jasonkresch/quantum-entanglement/media/vertical-cosmic-ray-telescope-3.jpg

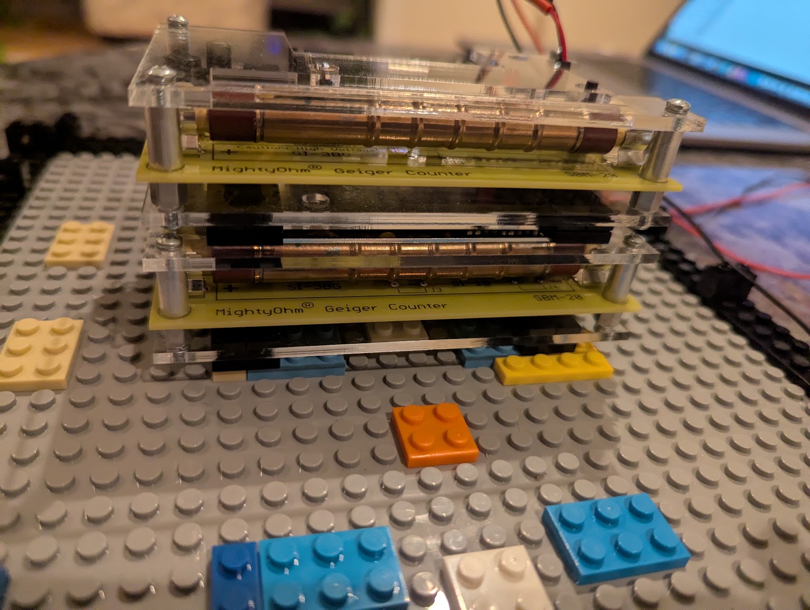
media/vertical-cosmic-ray-telescope-3.jpg
