jasonkresch/quantum-entanglement/related-docs/Entanglement-Demo-Shopping-List.pdf

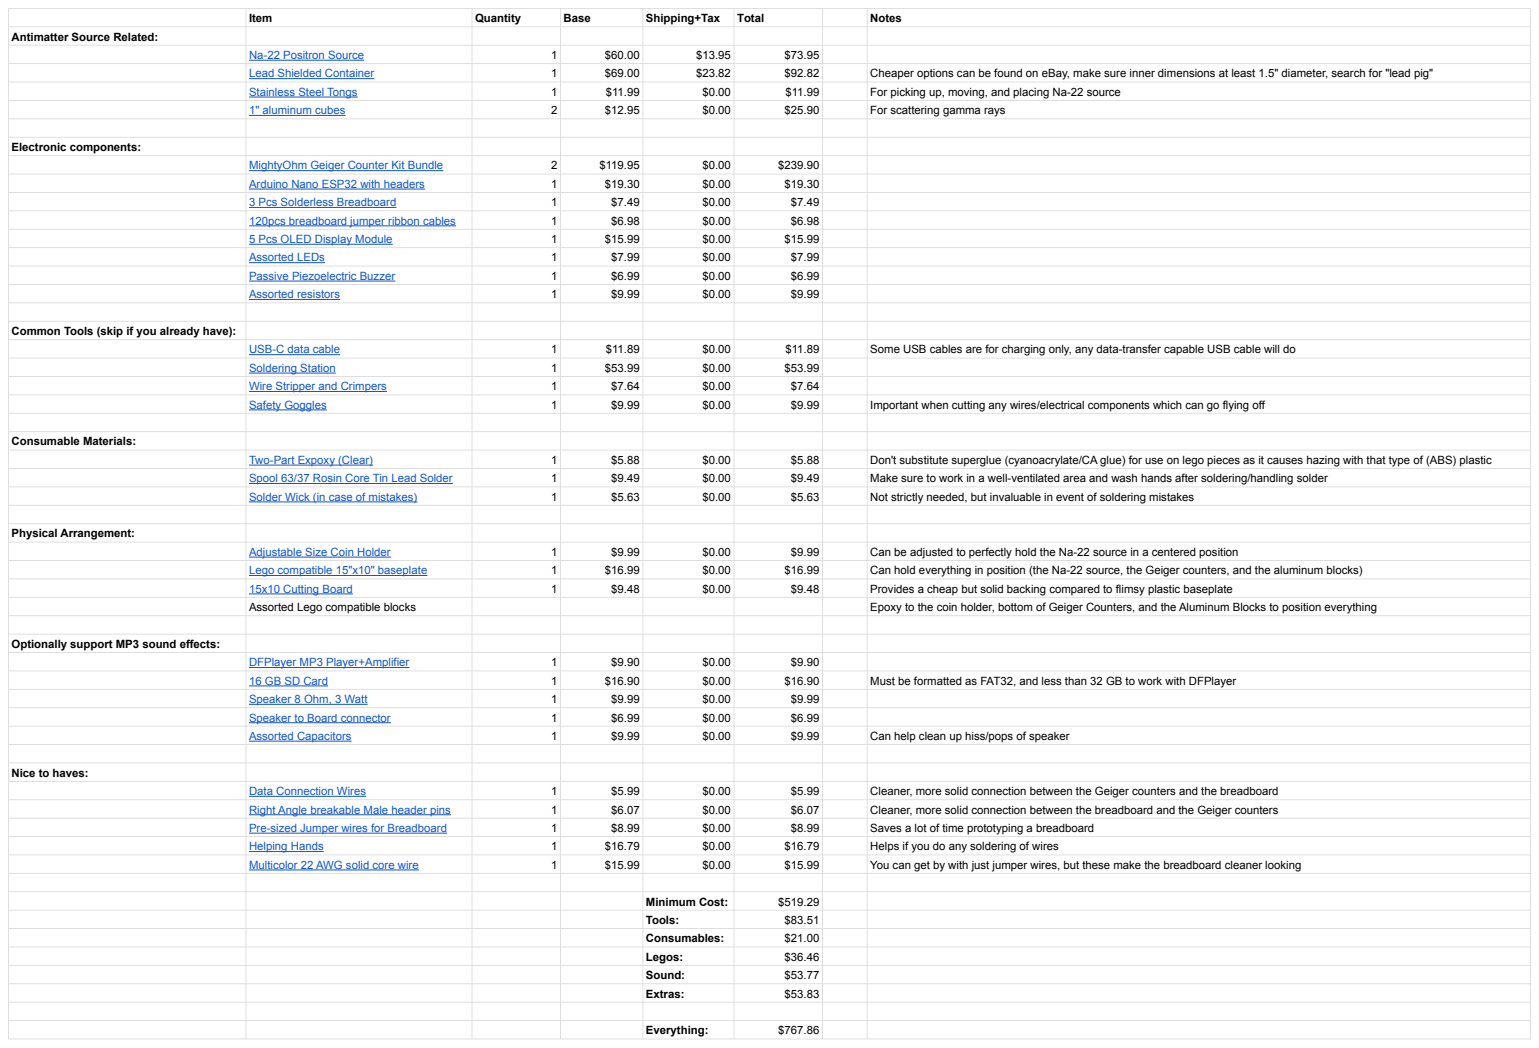
[picture p18: page 1]
Item; Quantity; Base; Shipping+Tax; Total; Notes; Na-22 Positron Source; Lead Shielded Container; Cheaper options can be found on eBay, make sure inner dimensions at least 1.5" diameter, search for "lead pig"; Stainless Steel Tongs; For picking up, moving, and placing Na-22 source; 1" aluminum cubes; For scattering gamma rays; Electronic components:; MightyOhm Geiger Counter Kit Bundle; Arduino Nano ESP32 with headers; 3 Pcs Solderless Breadboard; 120pcs breadboard jumper ribbon cables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

Antimatter Source Related:

Common Tools (skip if you already have):

Optionally support MP3 sound effects:

Nice to haves:
