jasonkresch/quantum-entanglement/(commit log)

2026-08-09 Update README.md
    Added a wiring diagram for the ESP32
2026-08-09 Update README.md
    Added more details regarding experiments and wiring to the speaker.
2026-08-10 Added screen shot of arduino IDE
2026-08-10 Added pin diagram to repository
2026-08-10 Update README.md
    Added directions for testing after successful wiring and installation of microcontroller code.
2026-08-10 Update README.md
    Added instructions on wiring to Geiger counters
2026-08-11 Update README.md
    Added sample output and field descriptions for the logger output.
